HardwareArt/textmachine/(list of files, cad)

Other CAD files:
board/current/HA_Tmach_Power.f3z
