HardwareArt/textmachine/docs/ABX00019-full-pinout.pdf

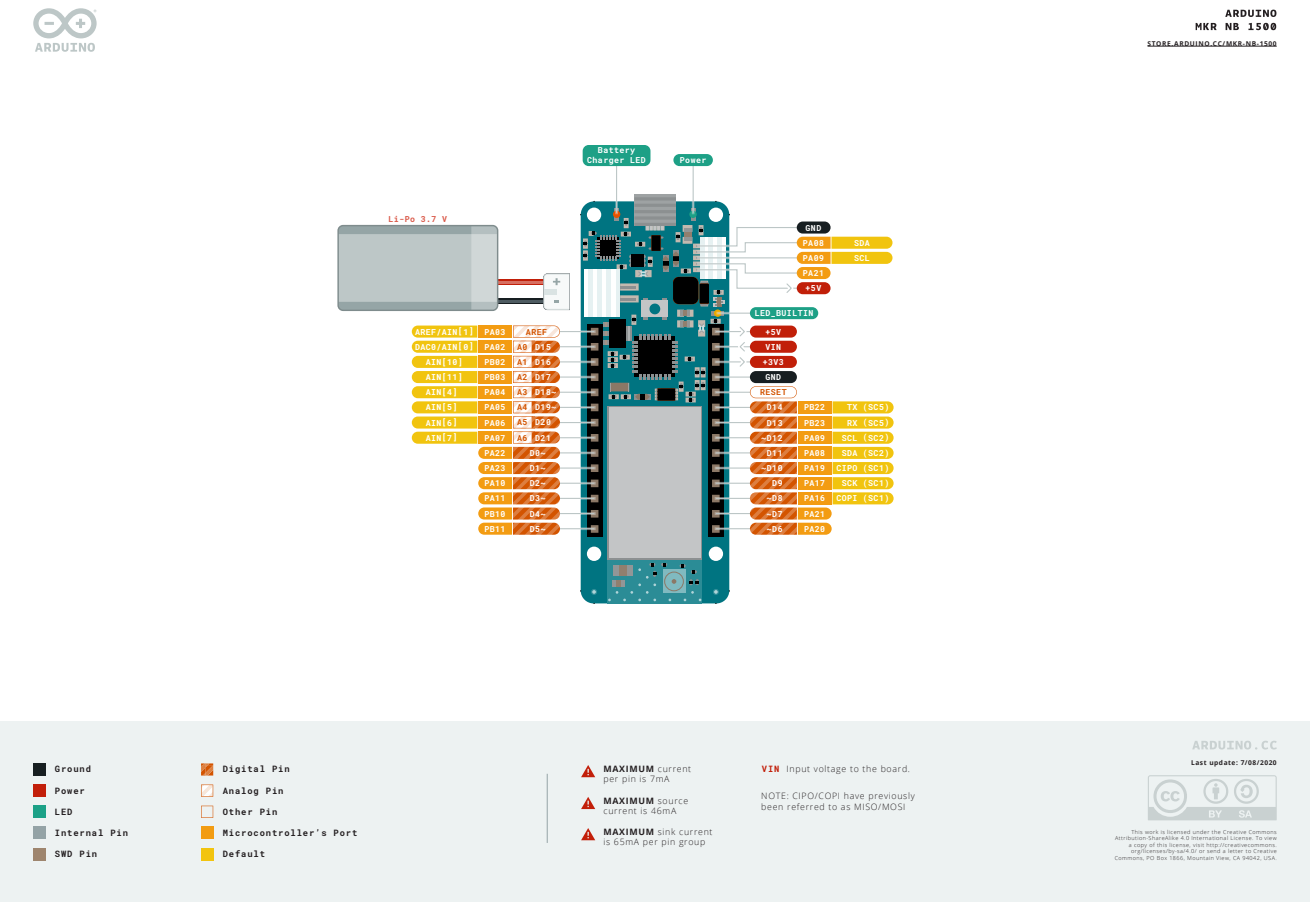
[picture p1: page 1]

STORE.ARDUINO.CC/MKR-NB-1500

MAXIMUM current
per pin is 7mA
MAXIMUM source
current is 46mA
MAXIMUM sink current
is 65mA per pin group

VIN Input voltage to the board.

NOTE: CIPO/COPI have previously
been referred to as MISO/MOSI

This work is licensed under the Creative Commons
Attribution-ShareAlike 4.0 International License. To view
a copy of this license, visit http://creativecommons.
org/licenses/by-sa/4.0/ or send a letter to Creative
Commons, PO Box 1866, Mountain View, CA 94042, USA.

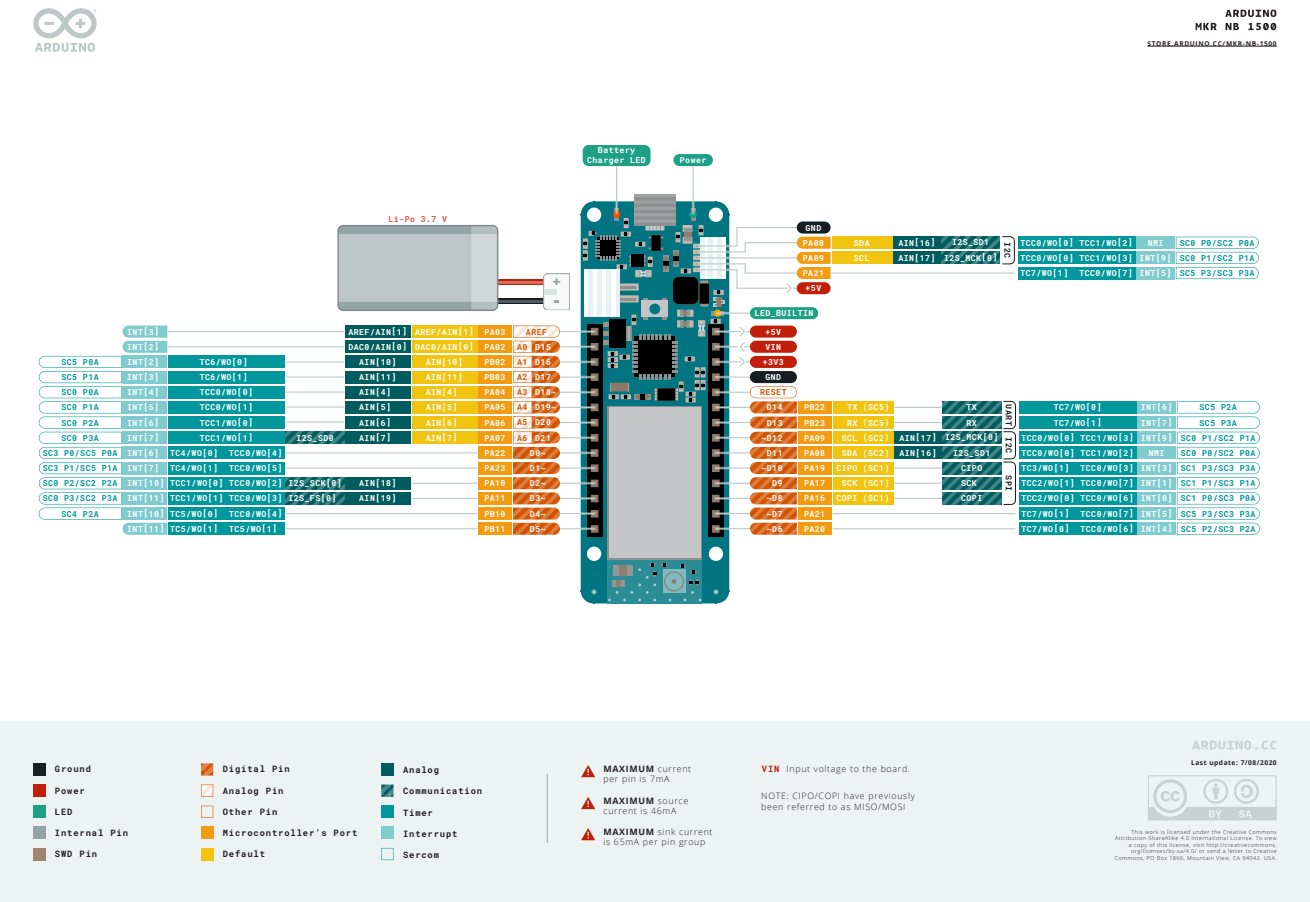
[picture p2: page 2]

VIN Input voltage to the board.

NOTE: CIPO/COPI have previously
been referred to as MISO/MOSI

## BOTTOM

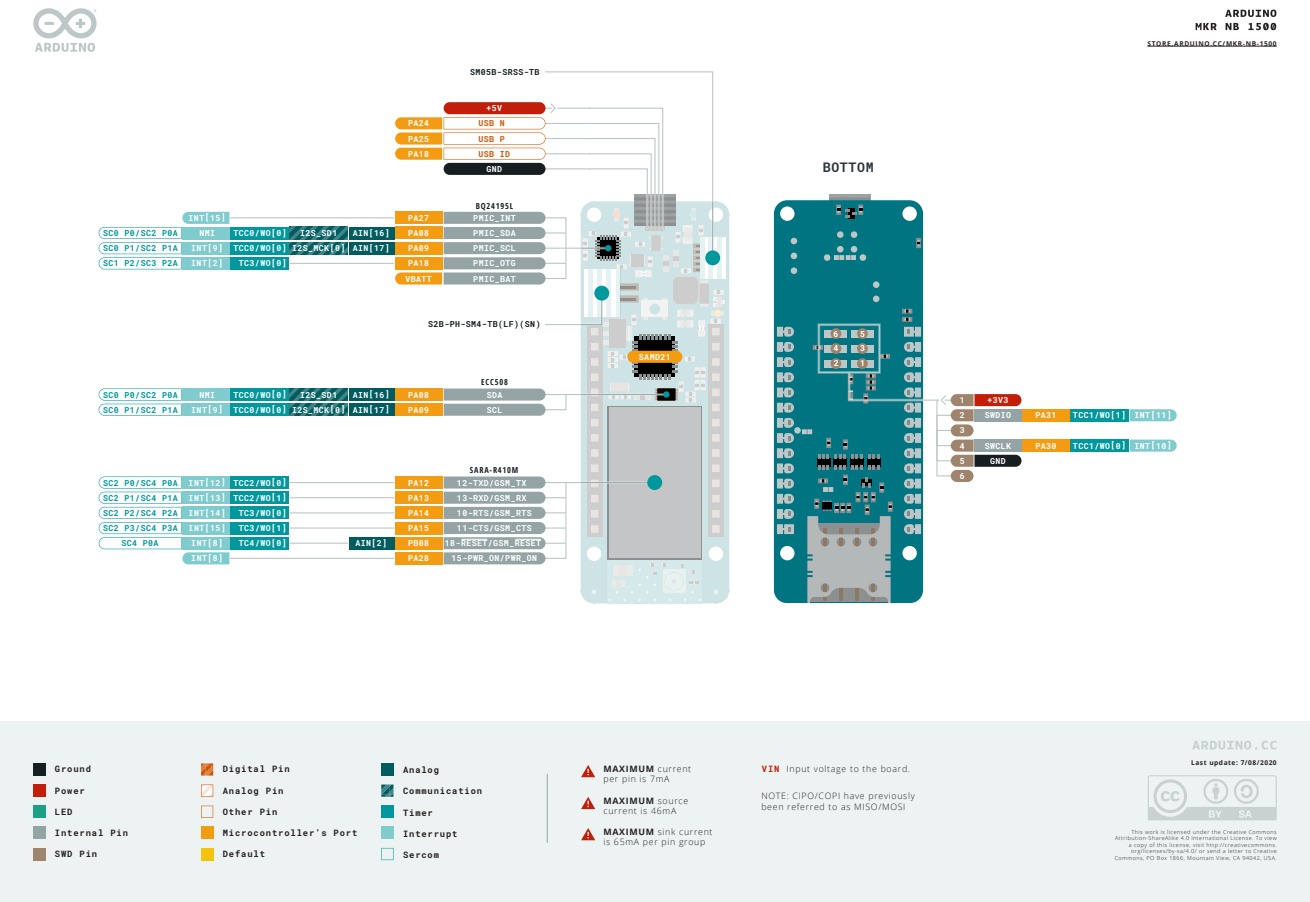
[picture p3: page 3]
Analog; Communication; Timer; Interrupt; Sercom; Ground; Power; LED; Digital Pin; Analog Pin; Other Pin; Last update: 7/08/2020; 15-PWR_ON/PWR_ON; 18-RESET/GSM_RESET; 11-CTS/GSM_CTS; 10-RTS/GSM_RTS; 13-RXD/GSM_RX; 12-TXD/GSM_TX; SARA-R410M; TCC2/WO[0] TCC2/WO[1] TC3/WO[0] TC3/WO[1] TC4/WO[0]; INT[12] INT[13] INT[14] INT[15]; INT[8]; AIN[2]; SDA SCL; ECC508; AIN[17]; TCC0/WO[0]; AIN[16]; NMI INT[9]; I2S_SD1 I2S_MCK[0]; PA27 PA08 PA09 PA18 VBATT; PMIC_OTG PMIC_BAT; PMIC_SCL; PMIC_SDA; PMIC_INT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

MAXIMUM current
per pin is 7mA
MAXIMUM source
current is 46mA

VIN Input voltage to the board.

NOTE: CIPO/COPI have previously
been referred to as MISO/MOSI
