HardwareArt/textmachine/board/current/power_board_v2.0.kicad_pcb

## KiCad design board/current/power_board_v2.0.kicad_pcb (2026-11-11)

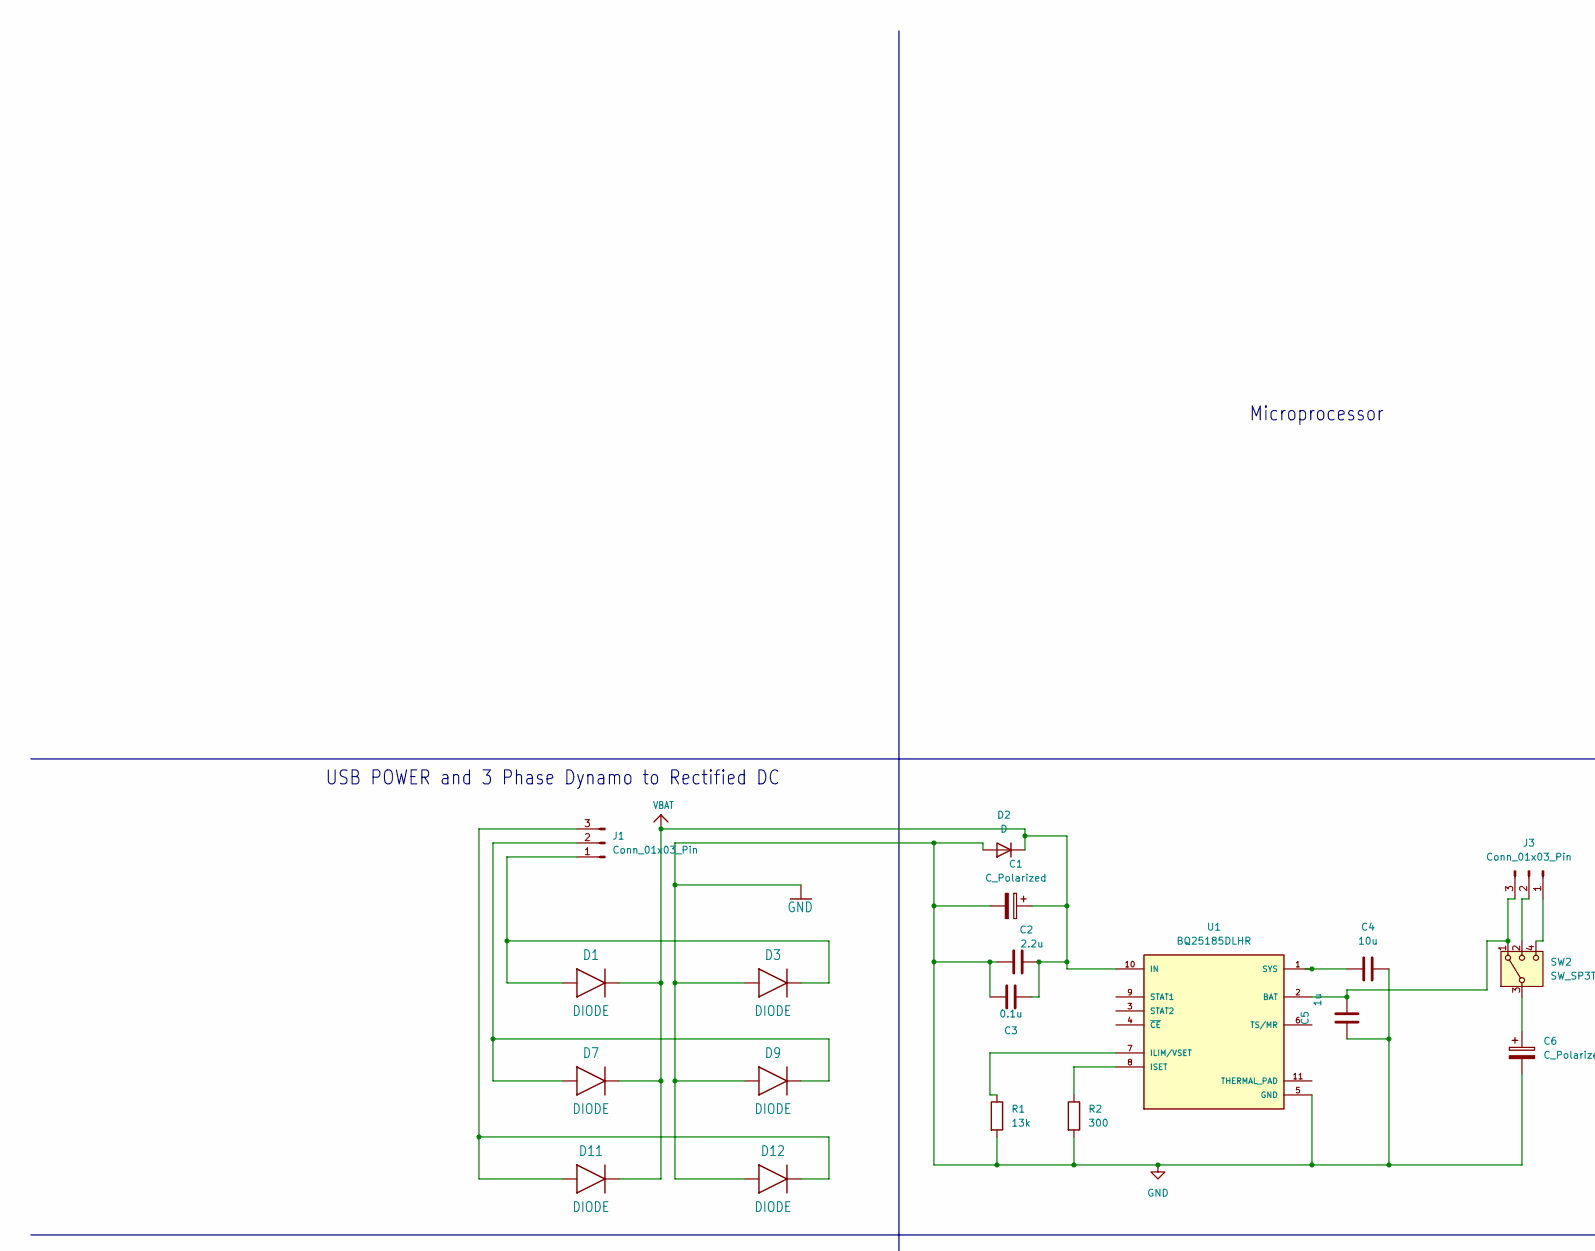
[picture p4: schematic power_board_v2.0.kicad_sch, part in row 1, column 1]

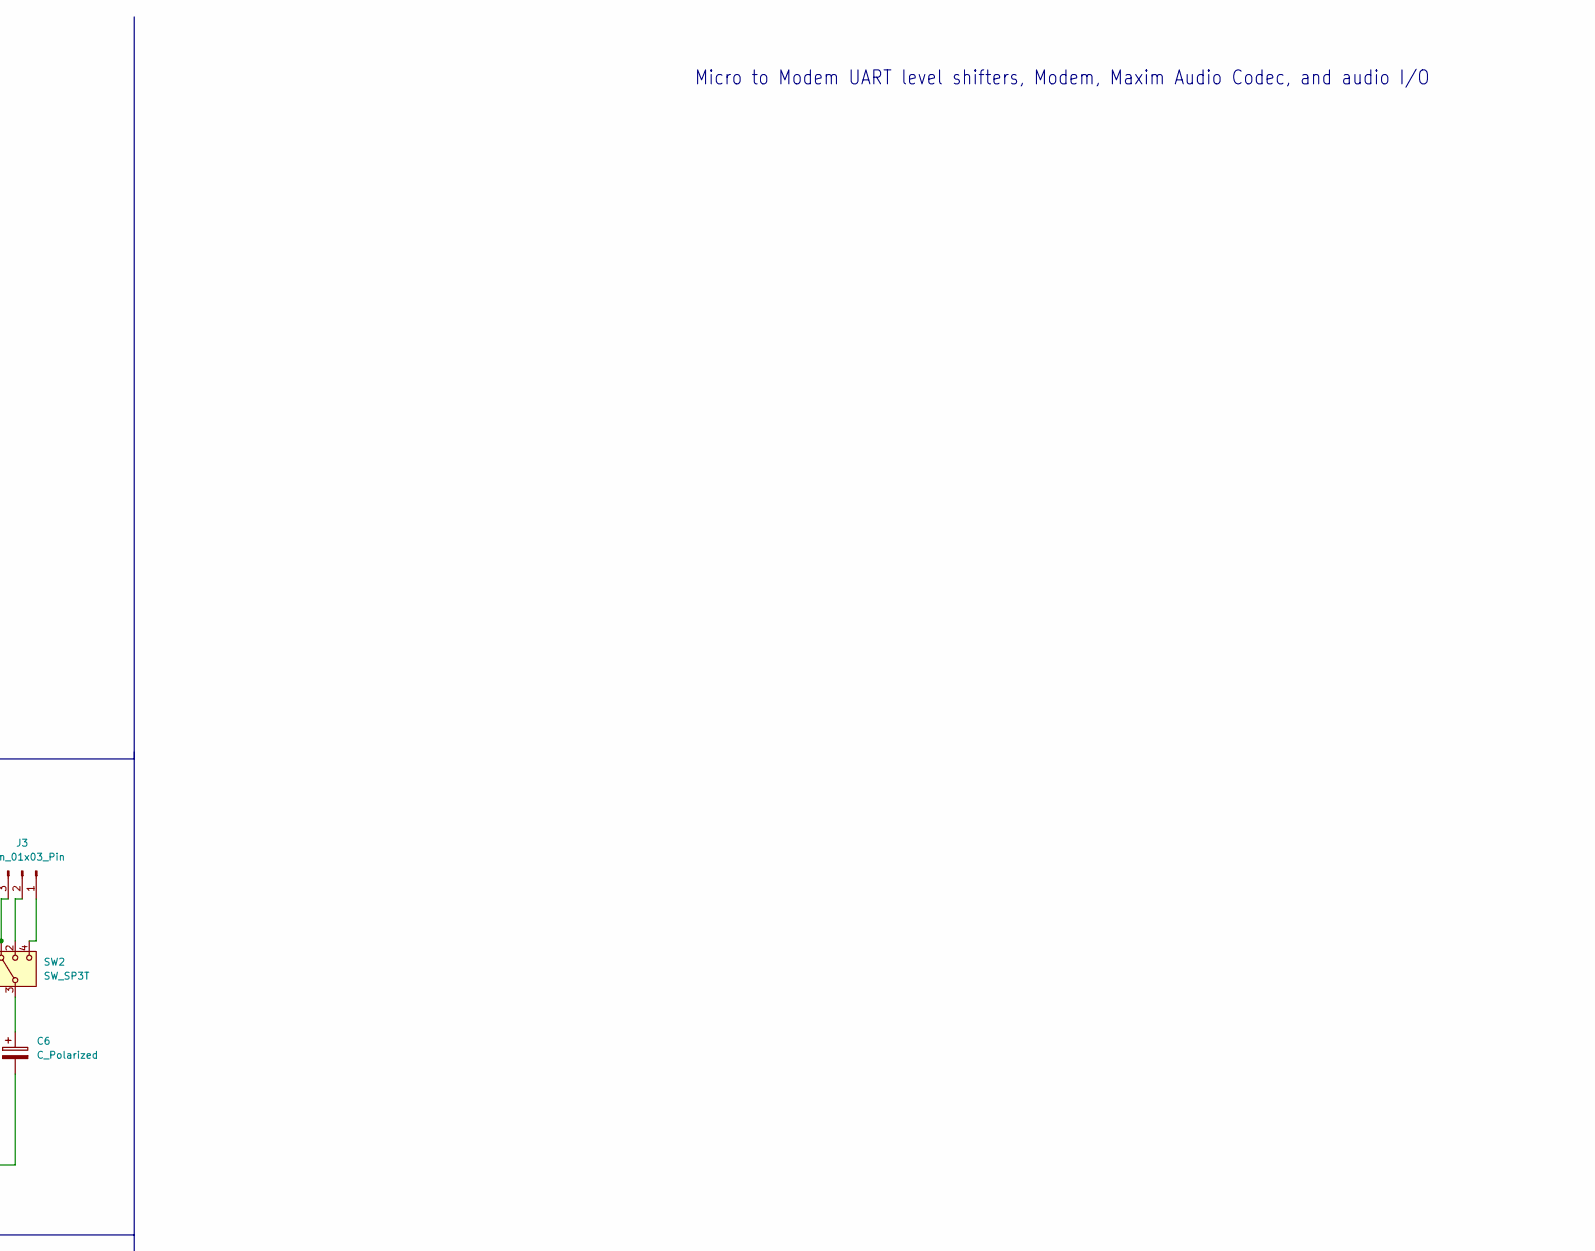
[picture p5: schematic power_board_v2.0.kicad_sch, part in row 1, column 2]

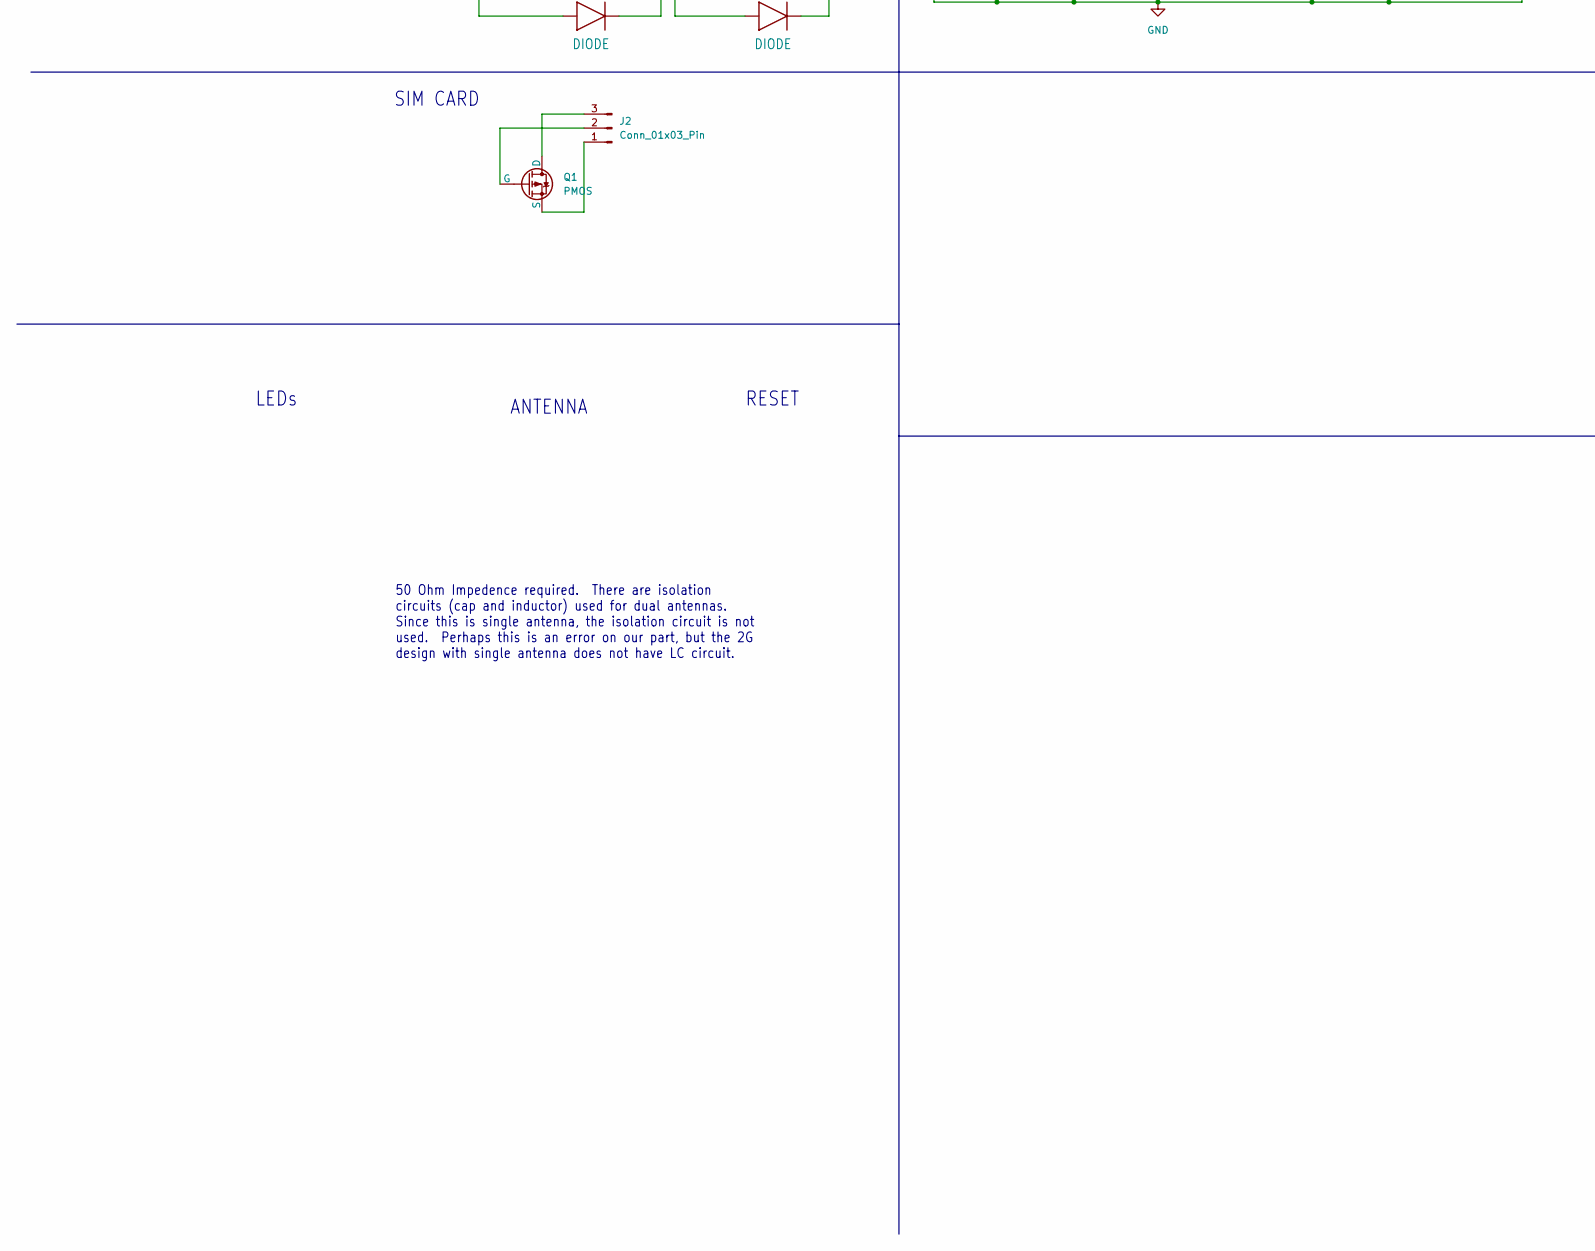
[picture p6: schematic power_board_v2.0.kicad_sch, part in row 2, column 1]

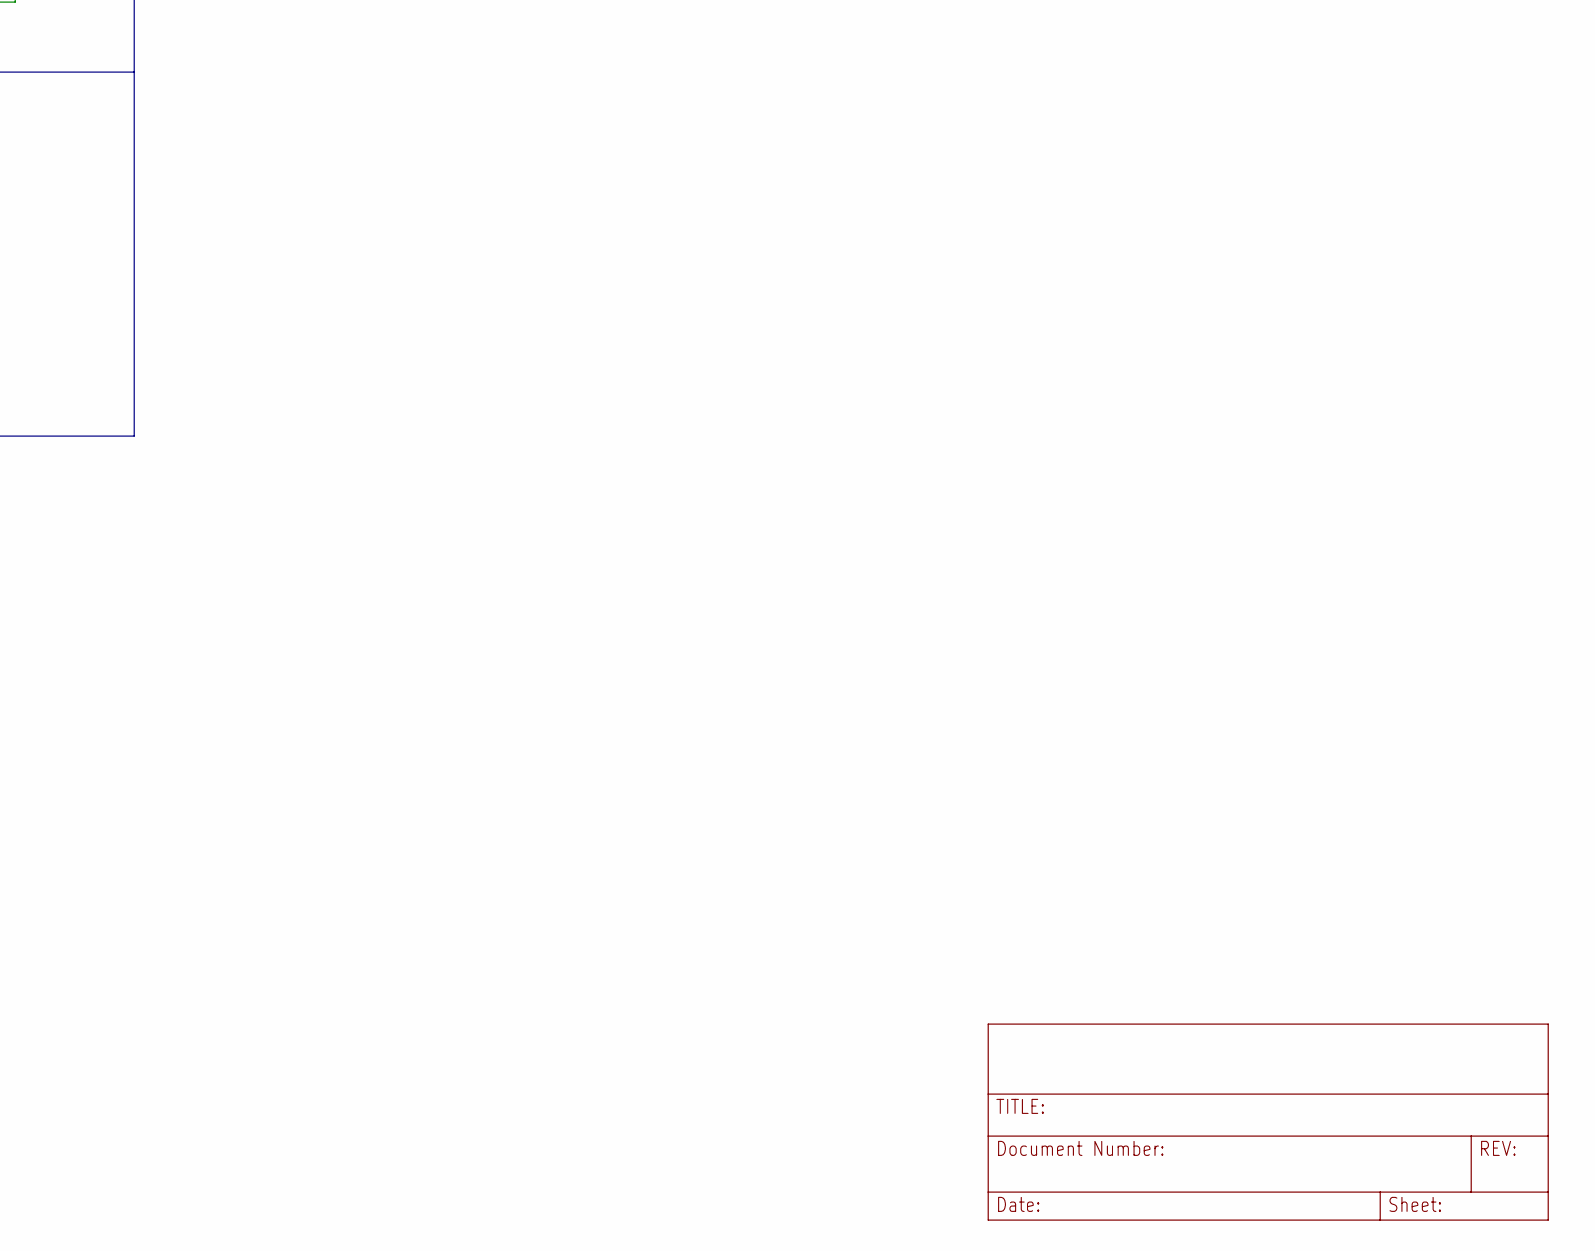
[picture p7: schematic power_board_v2.0.kicad_sch, part in row 2, column 2]

Parts:
C1, C6: C_Polarized; CP_Radial_D8.0mm_P5.00mm
C2: 2.2u; C_0402_1005Metric
C3: 0.1u; C_0402_1005Metric
C4: 10u; C_0402_1005Metric
C5: 1u; C_0402_1005Metric
D1, D3, D7, D9, D11, D12: DIODE; D_SOD-123
D2: D; D_DO-15_P10.16mm_Horizontal
J1, J2, J3: Conn_01x03_Pin; PinHeader_1x03_P2.54mm_Vertical
Q1: PMOS; SOT-23
R1: 13k; R_01005_0402Metric
R2: 300; R_01005_0402Metric
SW2: SW_SP3T; SW_Push_2P1T_Toggle_CK_PVA1xxH1xxxxxxV2
U1: BQ25185DLHR; Texas_DLH0010A_WSON-10-1EP_2.2x2mm_P0.4mm_EP0.9x1.5mm; PARTREV OCTOBER 2023

Connections:
GND: C1.2, C2.1, C3.1, C4.2, C5.1, C6.2, D2.2 (A), D3.2 (A), D9.2 (A), D12.2 (A), R1.2, R2.2, U1.5 (GND)
unnamed: C6.1, SW2.3
unnamed: D1.2 (A), D3.1 (C), J1.1
unnamed: D7.2 (A), D9.1 (C), J1.2
unnamed: D11.2 (A), D12.1 (C), J1.3
unnamed: J2.1, Q1.3 (S)
unnamed: J2.2, Q1.2 (G)
unnamed: J2.3, Q1.1 (D)
unnamed: J3.1, SW2.4
unnamed: J3.2, SW2.2
unnamed: C5.2, J3.3, SW2.1, U1.2 (BAT)
unnamed: R1.1, U1.7 (ILIM/VSET)
unnamed: R2.1, U1.8 (ISET)
unnamed: C4.1, U1.1 (SYS)
VBAT: C1.1, C2.2, C3.2, D1.1 (C), D2.1 (K), D7.1 (C), D11.1 (C), U1.10 (IN)

Notes on the sheet:
50 Ohm Impedence required. There are isolation circuits (cap and inductor) used for dual antennas. Since this is single antenna, the isolation circuit is not used. Perhaps this is an error on our part, but the 2G design with single antenna does not have LC circuit.
Micro to Modem UART level shifters, Modem, Maxim Audio Codec, and audio I/O
RESET
USB POWER and 3 Phase Dynamo to Rectified DC
ANTENNA
SIM CARD
Microprocessor
LEDs

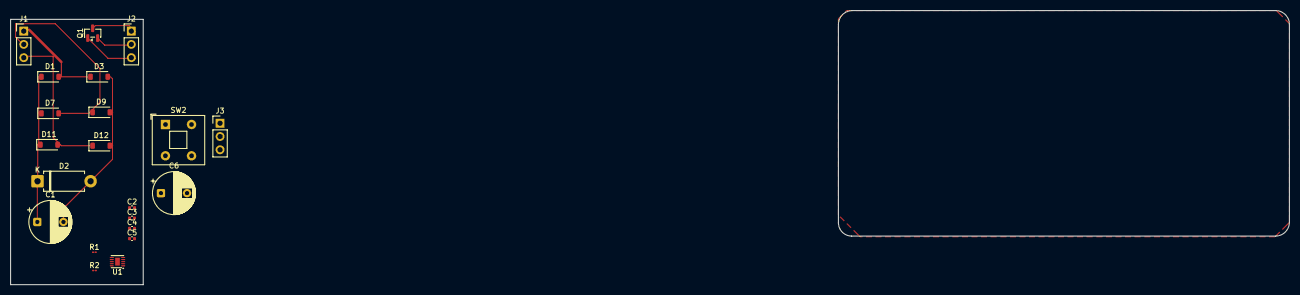
[picture p8: board power_board_v2.0.kicad_pcb from above]

Board: 2 copper layers, 25.4 x 50.8 mm, 21 parts (0 on the bottom side), 15 nets.
