HardwareArt/textmachine/board/current/HA_Tmach_Power.sch

## EAGLE design board/current/HA_Tmach_Power.sch (2026-11-06)

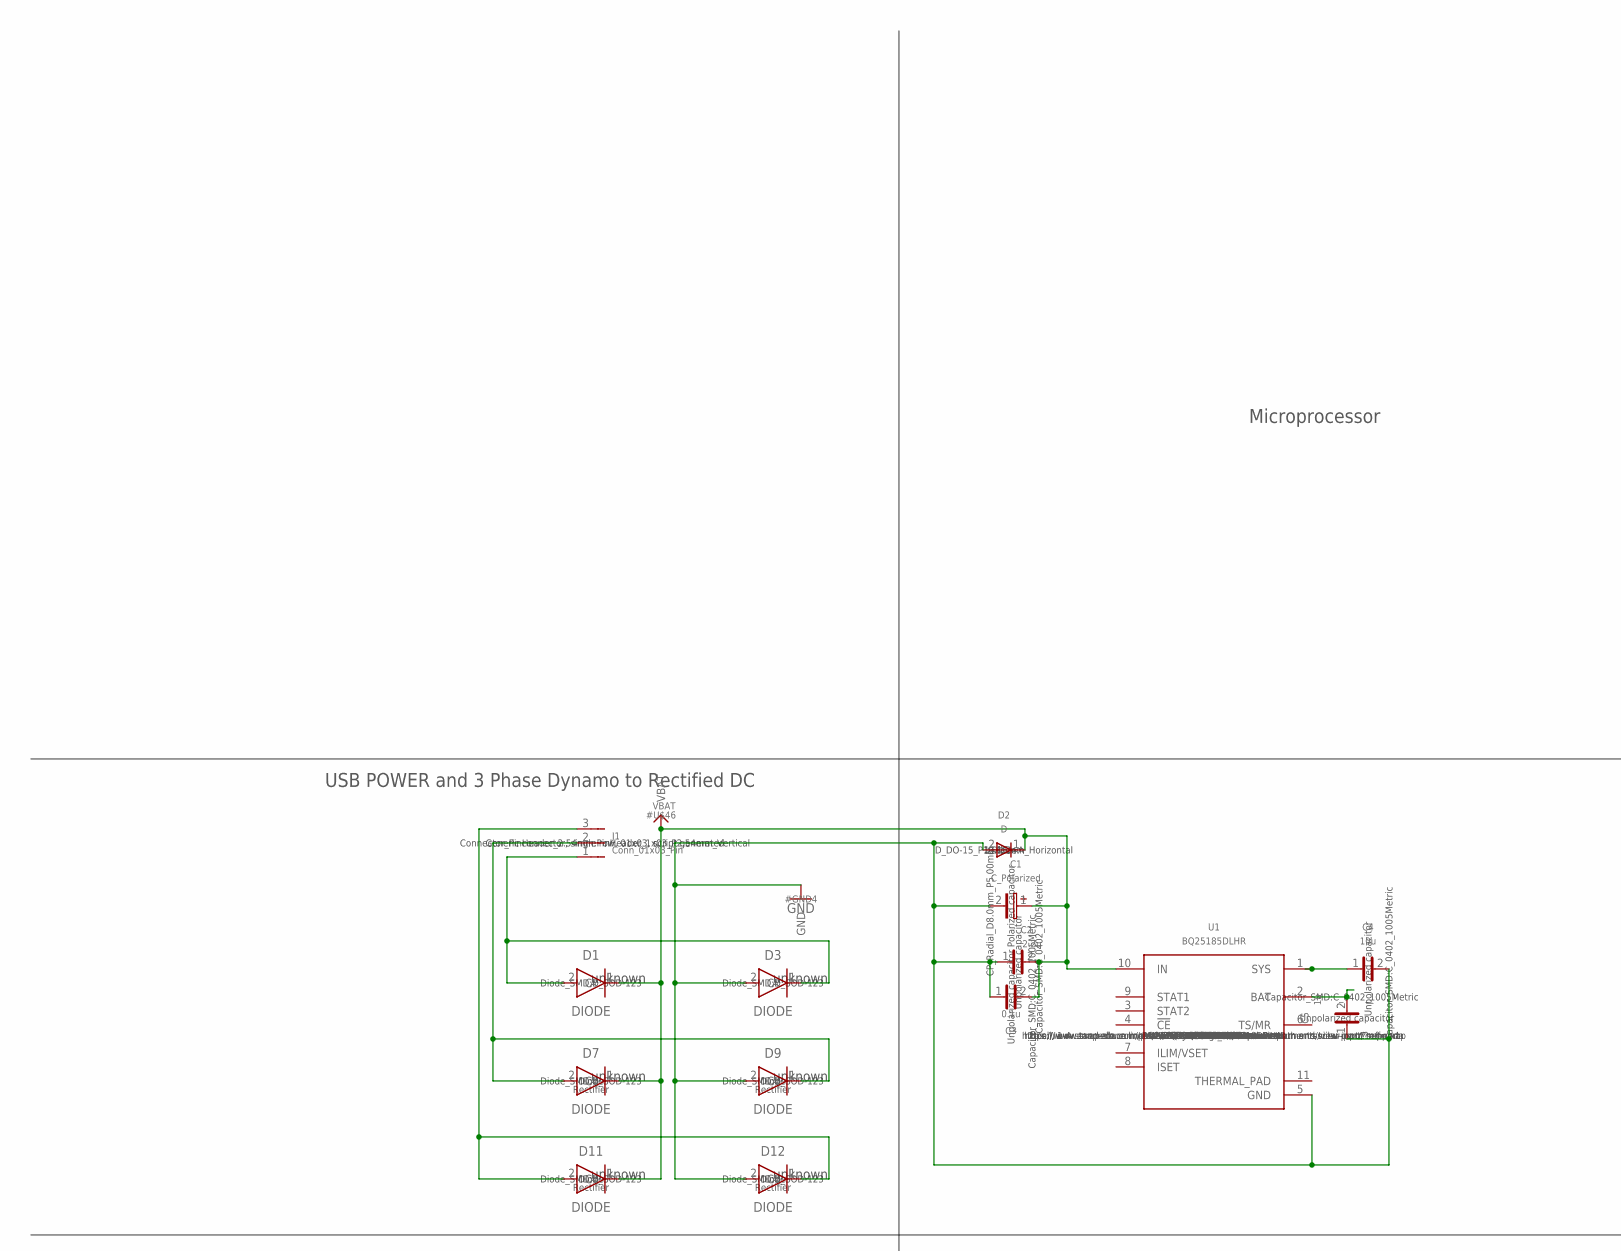
[picture p9: schematic HA_Tmach_Power.sch, part in row 1, column 1]

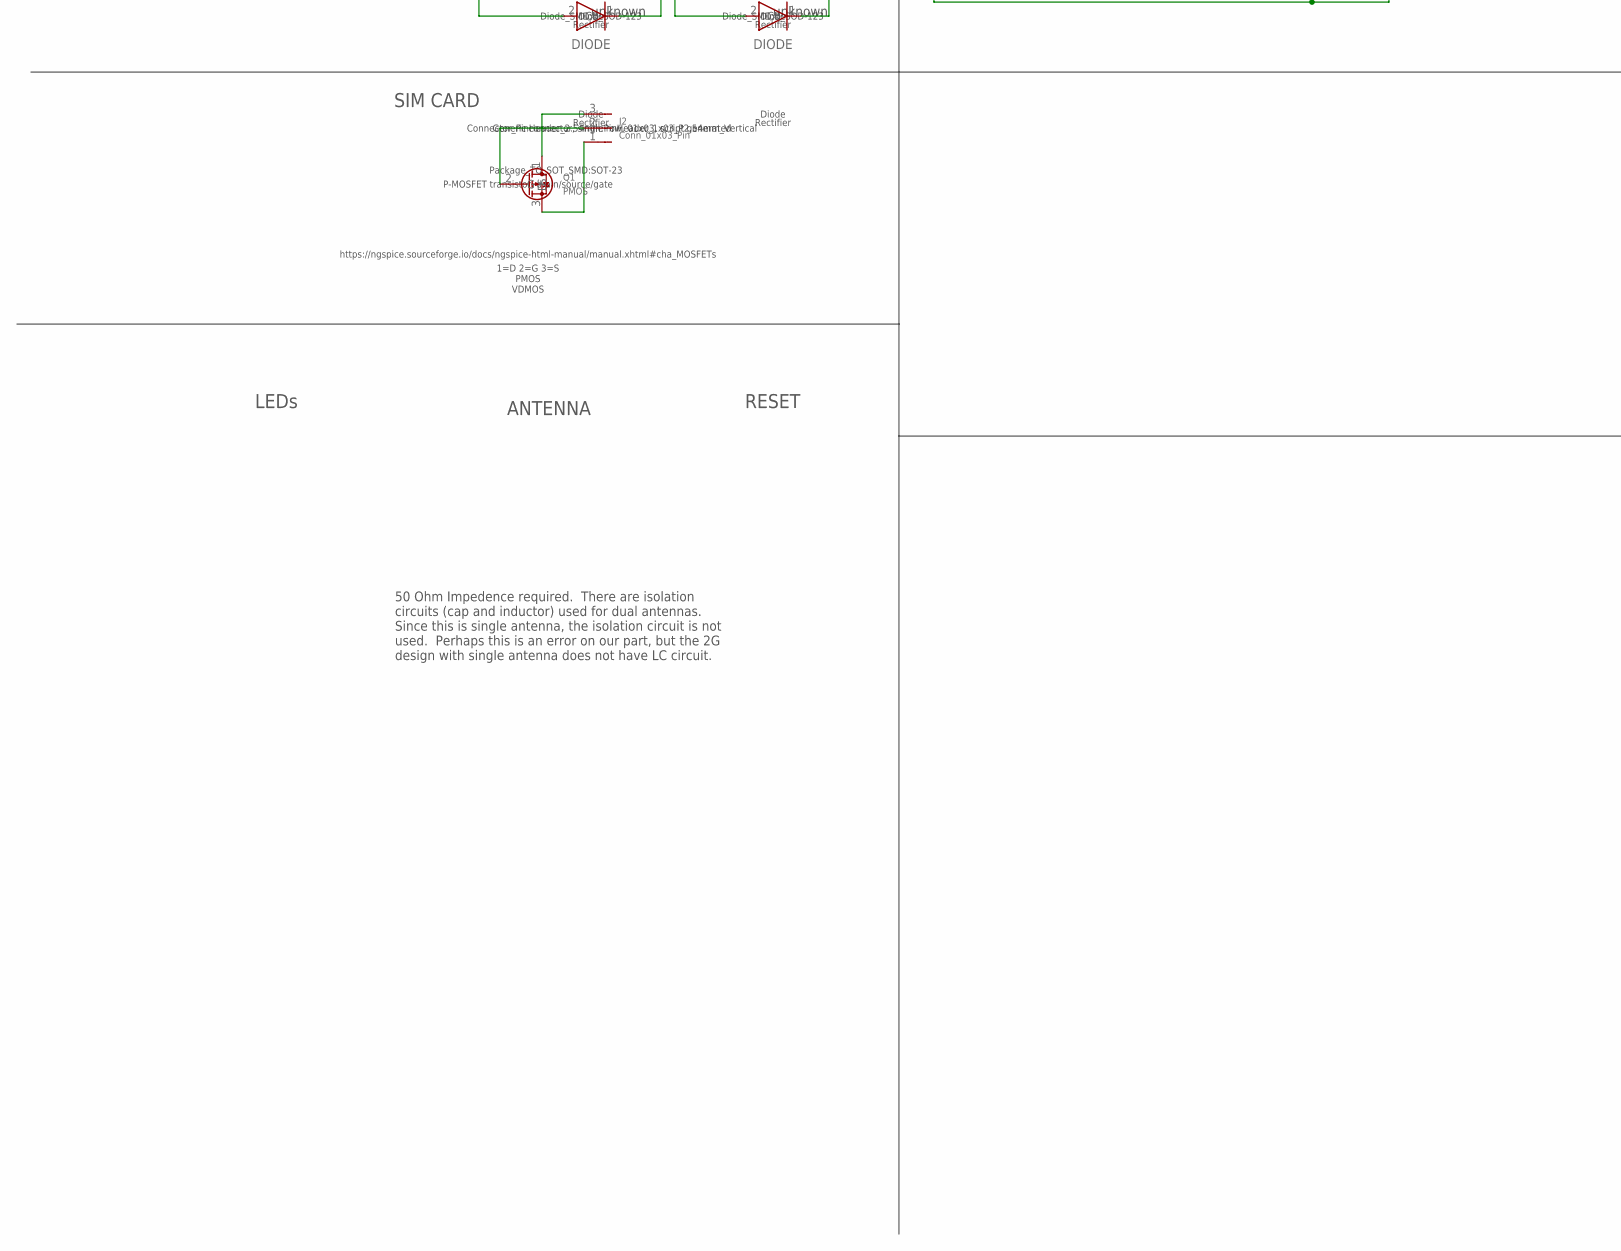
[picture p10: schematic HA_Tmach_Power.sch, part in row 2, column 1]

Parts:
C1: C_Polarized; CP_RADIAL_D8.0MM_P5.00MM
C2: 2.2u; CAPACITOR_SMD_C_0402_1005METRIC
C3: 0.1u; CAPACITOR_SMD_C_0402_1005METRIC
C4: 10u; CAPACITOR_SMD_C_0402_1005METRIC
C5: 1u; CAPACITOR_SMD_C_0402_1005METRIC
D1, D3, D7, D9, D11, D12: DIODE; HA_FONA_LARA_20-IMPORT-FPS_DIOM5336X265N
D2: D; D_DO-15_P10.16MM_HORIZONTAL
J1, J2: Conn_01x03_Pin; CONNECTOR_PINHEADER_2.54MM_PINHEADER_1X03_P2.54MM_VERTICAL
Q1: PMOS; PACKAGE_TO_SOT_SMD_SOT-23
U1: BQ25185DLHR; BQ25185DLHR_IC_BQ25185DLHR; PARTREV OCTOBER 2023

Connections:
GND: C1.2, C2.1, C3.1, C4.2, C5.1, D2.2 (A), D3.2 (A), D9.2 (A), D12.2 (A), U1.5 (GND)
unnamed: D11.2 (A), D12.1 (C), J1.3 (PIN_3)
unnamed: C4.1, U1.1 (SYS)
unnamed: C5.2, U1.2 (BAT)
unnamed: J2.1 (PIN_1), Q1.3 (S)
unnamed: D7.2 (A), D9.1 (C), J1.2 (PIN_2)
unnamed: D1.2 (A), D3.1 (C), J1.1 (PIN_1)
unnamed: J2.3 (PIN_3), Q1.1 (D)
unnamed: J2.2 (PIN_2), Q1.2 (G)
VBAT: C1.1, C2.2, C3.2, D1.1 (C), D2.1 (K), D7.1 (C), D11.1 (C), U1.10 (IN)

Notes on the sheet:
50 Ohm Impedence required. There are isolation circuits (cap and inductor) used for dual antennas. Since this is single antenna, the isolation circuit is not used. Perhaps this is an error on our part, but the 2G design with single antenna does not have LC circuit.
Micro to Modem UART level shifters, Modem, Maxim Audio Codec, and audio I/O
RESET
USB POWER and 3 Phase Dynamo to Rectified DC
ANTENNA
SIM CARD
Microprocessor
LEDs
