HardwareArt/textmachine/(commit log)

2026-06-02 Added red screen before trying to connect to reduce ambiguity in power testing
2026-06-19 Solidified contacts logic with non volatile memory implementation and began single input debug implemntation, reworked keyboard so that it can work in different input modes, next step is implementing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
    [UI.cpp, UI.h, contacts.cpp, contacts.h, keyboard.cpp, keyboard.h, textmachcap.ino, types.h]
2026-11-11 update to include a "rocker" switch that has charge, open, and load modes.
    The board is now 95% done. Just have to agree on:
    1. connectors to Dynamo, rocker switch, and IoT.
    2. Double check all parts/footprints.
    3. Make sure layout has been designed for 1A max current to all things going into cap charge chip, and the ICs output supercap line as well.
